EatingVoltage/KNOBZ/hw/knobz kit bom.xlsx

KNOBZ BOM | total price | 45.81
part name trivial | part name trading | link | price per piece | parts price | amt
front plate |  |  | 3 | 3 | 1
pcb |  |  | 14 | 14 | 1
backplate |  |  | 3 | 3 | 1
 |  |  |  | 0
potentiometer | rv09 |  | 0.1 | 2 | 20
fader |  |  | 1 | 10 | 10
oled | 0.91 Inch 128x32 IIC I2C white OLED | https://de.aliexpress.com/item/1005008640132638.html | 1.3 | 1.3 | 1
lidar | vl53l0x |  | 1.5 | 1.5 | 1
minijack connector | PJ-3240-5A |  | 0.15 | 0.45 | 3
subminiature toggle | smts-102 | https://de.aliexpress.com/item/4000226769848.html | 1 | 1 | 1
 |  |  |  | 0
M2x4 screw panhead | M2x4 screw panhead - H1.5mm | https://www.aliexpress.com/item/1005002357962115.html | 0.025 | 0.35 | 14
M2x10 SK |  |  |  | 0 | 14
threaded insert | M2x7 round Standoff Spacer Female M2 Brass Threaded Spacer | https://de.aliexpress.com/item/1005003126118423.html?scm_id=1007.40196.442820.0&scm-url=1007.40196.442820.0 | 0.015 | 0.21 | 14
 |  |  |  | 0
3dp case |  |  | 2 | 2 | 1
3dp bottom spacer |  |  | 1 | 1 | 1
 |  |  |  | 0
knobs |  |  | 0.2 | 4 | 20
fadercaps |  |  | 0.2 | 2 | 10
 |  |  |  | 0
 |  |  |  | 0
