EatingVoltage/KNOBZ/hw/case.3mf

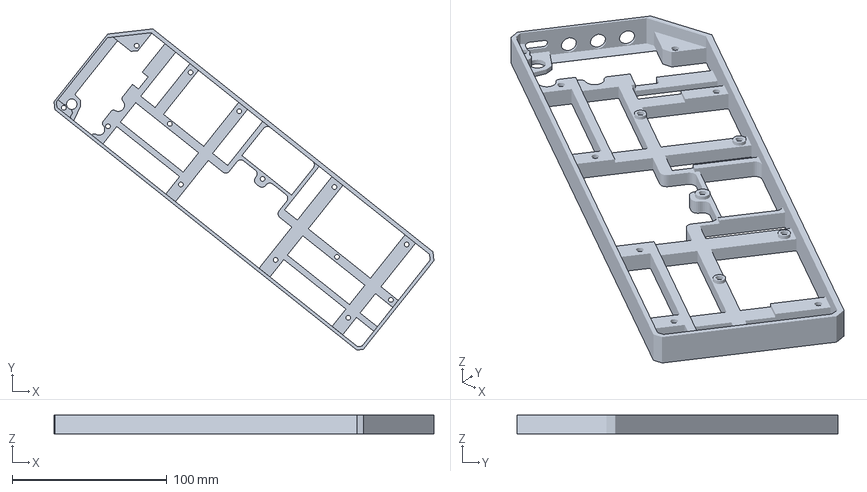
[picture p1: CAD file, 2026-10-17]
hw/case.3mf
245.4 x 207.5 x 12.2 mm
