EatingVoltage/KNOBZ/hw/bottom spacer.3mf

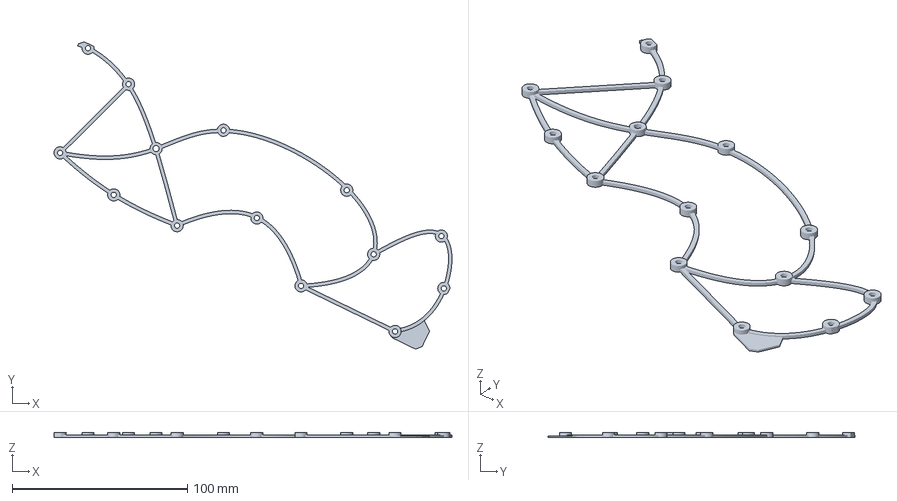
[picture p2: CAD file, 2026-10-17]
hw/bottom spacer.3mf
227.1 x 175.3 x 3.00 mm
