EatingVoltage/KNOBZ/src/io/button.h

#include <Arduino.h>

// this file contains structures for easily reading buttons. provides advanced reading: tapped, held etc...
#define BUTTON_LONG_PRESS_TIME 500
#define BUTTON_TAP_TIME 300
#define BUTTON_AMT 4 // buttons outputting midi notes

struct Button
{
    bool input = false;   // input buffer
    bool didHold = false; // this stores if button was long pressed
    long t0 = 0;

    // user vars. read these to use button.
    bool fell = false;    // read this to see if fell
    bool rose = false;    // read this to see if rose
    bool pressed = false; // read this to see if buttton is pressed at the time
    bool tapped = false;  // read this to see if tapped
    bool held = false;    // read this to see if held
};

Button minButton;
Button maxButton;
Button modeButton;
Button sensorSwitch; // lidar toggle switch (bit 7) - latches, sends a held midi note
Button controllerButton[BUTTON_AMT];

void updateButton(Button &myButton, bool inputVal, long tFrame) // inputVal false = button pressed down
{
    // set vars to default state
    myButton.tapped = false;
    myButton.held = false;
    myButton.fell = false;
    myButton.rose = false;

    myButton.input = inputVal;                // read input
    if (!myButton.input && !myButton.pressed) // new button press
    {
        myButton.didHold = false; // reset temp variable
        myButton.pressed = true;
        myButton.fell = true;
        myButton.t0 = tFrame;
    }

    if (myButton.input && myButton.pressed) // button released
    {
        myButton.pressed = false;
        myButton.rose = true;

        if (tFrame - myButton.t0 < BUTTON_TAP_TIME)
        {
            myButton.tapped = true;
        }
    }

    if (!myButton.didHold && myButton.pressed && (tFrame - myButton.t0 > BUTTON_LONG_PRESS_TIME)) // if button was held long enough
    {
        myButton.held = true;
        myButton.didHold = true;
    }
}

// seed the sensor switch from the current pin state so an already-on switch at
// power-up does NOT fire a note on the first frame (boot-edge suppression).
// requires shiftInUpdate() to have run (inputValues valid).
void sensorSwitchInit()
{
    bool b = shiftInReadBit(7); // false = switch in sensor-ON position (active low)
    sensorSwitch.input = b;
    sensorSwitch.pressed = !b;
}

void updateButtons()
{
    updateButton(minButton, shiftInReadBit(4), millis());
    updateButton(maxButton, shiftInReadBit(5), millis());
    updateButton(modeButton, shiftInReadBit(6), millis());
    updateButton(sensorSwitch, shiftInReadBit(7), millis());
    updateButton(controllerButton[0], shiftInReadBit(0), millis());
    updateButton(controllerButton[1], shiftInReadBit(1), millis());
    updateButton(controllerButton[2], shiftInReadBit(2), millis());
    updateButton(controllerButton[3], shiftInReadBit(3), millis());
}

void debugButtons()
{

    // debugging
    for (byte i = 0; i < 7; i++)
    {
        if (shiftInReadBit(i))
        {
            oledAt(i * 20, 1, 0);
            oled.print(i);
        }
        else
            oledPrint(F("  "), i * 15, 1, 0);
    }

    // if (minButton.pressed)
    //     oledPrint("min");
    // else if (maxButton.pressed)
    //     oledPrint("max");
    // else if (modeButton.pressed)
    //     oledPrint("mod");
    // else oledPrint("   ");
    // for (byte i = 0; i < 4; i++)
    // {
    //     if (controllerButton[i].fell)
    //     {

    //         oledPrint("Button " + String(i) + " pressed", 0, 0, 1);
    //         delay(500);
    //     }
    // }
}
