EatingVoltage/KNOBZ/src/draw.h

#include <Arduino.h>

// draws presetName x-centered in the big font on the given row.
// animate = reveal letter-by-letter (~60ms/char, like the KNOBZ splash).
// trailing blanks are trimmed; an all-blank name draws nothing.
void drawNameCentered(byte row, bool animate)
{
    byte len = NAME_LEN;
    while (len > 0 && presetName[len - 1] == ' ')
        len--;
    if (len == 0)
        return; // unnamed slot -> leave the line blank

    oledAt((128 - len * 8) / 2, row, 1); // ZevvPeep8x16 is 8px wide
    for (byte i = 0; i < len; i++)
    {
        oled.print(presetName[i]);
        if (animate)
            myDelay(60);
    }
}

void showHeader() // shows cc and channel on top of oled
{
    oledAt(0, 0, 0);
    oled.print(F("CC: "));
    oled.print(knob[activeKnob].midiCC);

    byte x = 90;
    if (knob[activeKnob].midiChannel + 1 < 10)
        x += 8;
    oledAt(x, 0, 0);
    oled.print(F("CH: "));
    oled.print(knob[activeKnob].midiChannel + 1);
}

void showHome()
{
    oled.clear();
    showHeader();
    oledAt(0, 3, 0);
    oled.print(F("MIN:"));
    oledPrintPad3(knob[activeKnob].min);
    oledAt(85, 3, 0);
    oled.print(F("MAX:"));
    oledPrintPad3(knob[activeKnob].max);

    byte x = 58;
    if (activeKnob < 10)
        x += 4;
    oledAt(x, 0, 3);
    oled.print(activeKnob + 1);
}

byte oldActiveKnob = 0;

void drawMin(byte col, byte style)
{
    oledAt(col, 2, style);
    oled.print(F("MIN:"));
    oledPrintPad3(knob[activeKnob].min);
}

void drawMax(byte col, byte style)
{
    oledAt(col, 2, style);
    oled.print(F("MAX:"));
    oledPrintPad3(knob[activeKnob].max);
}

void drawHome()
{
    if (activeKnob != oldActiveKnob || redrawOled)
    {
        oldActiveKnob = activeKnob;
        if (minButton.pressed)
            drawMin(0, 1);
        else if (maxButton.pressed)
            drawMax(74, 1);
        else
            showHome();
        redrawOled = false; // reset flag
    }

    else if (minButton.fell)
        drawMin(0, 1);
    else if (maxButton.fell)
        drawMax(74, 1);
    else if (minButton.rose || maxButton.rose)
        showHome();
}
