EatingVoltage/KNOBZ/(commit log)

2020-09-06 saving not working yet
    [config.h, controller.h, main.cpp, menu.h, oled.h]
2020-09-06 nicer led animations, and startup
2020-09-10 added cc/ch conflict warning: cc/ch taken, small fixes
    [animateNeopixel.h, config.h, lidar.h, main.cpp, menu.h, midiIO.h, midiRouting.h, ws2812.h]
2020-09-10 Revert "added cc/ch conflict warning: cc/ch taken, small fixes"
    This reverts commit 1f6fa925f1a66c57c38a7c7b8362a31e5f2d43a0.
    [animateNeopixel.h, config.h, lidar.h, main.cpp, menu.h, midiIO.h, midiRouting.h, ws2812.h]
2020-09-10 cleaned up menu, added clear all, set all channels, reset min max routines
    [menu.h]
2020-09-10 added hardware pin for midi out indicator support
2020-09-20 porting to prototype 0.2.
2020-10-18 got usbmidi uartmidi conversion working and program memory down enough to fit!
2021-02-19 new hardware knob layout, bugfixes, menu repeats, self-initializing, memory optimisation
    [analogMux.h, config.h, controller.h, lidar.h, main.cpp, menu.h, sendMidi.h, shiftIn.h]
2021-03-18 fixing jitter by adding running average to all knobs
    [analogMux.h, animateNeopixel.h, config.h, controller.h, draw.h, main.cpp, menu.h, midiIO.h]
2021-03-20 added proper potentiometer software filtering
2021-04-13 bug fixes, small features
    [Ledling.h, analogMux.h, animateNeopixel.h, button.h, config.h, controller.h, draw.h, lidar.h]
2021-04-21 minor bugfixes, lidar working
    [controller.h]
2026-06-07 optimize flash, kill arduino String
2026-06-07 add button channel menu option
2026-06-07 add save slot naming
2026-06-07 fix oled value flicker
    [controller.h, menu.h]
2026-06-17 add lidar enable switch also sends midi note
2026-10-15 Add printable enclosure parts for owners
    Case, button cap (x7) and bottom spacer STLs from Fusion, plus a
    README with PETG / 0.2 mm / no-support print settings.
2026-10-15 Set all channels: show the real channel on first draw
    menu.currentVal is stale when the edit screen first opens; read the
    channel from the editing knob instead (stored 0-15, shown 1-16).
2026-10-15 Set all channels: drop duplicated channel print from PR #2 merge
    The merge kept both versions of the line, so the channel printed twice
    (channel 1 showed as "11").
2026-10-17 Add the hardware as built: the EasyEDA export, Y371 and Y377 as JLCPCB made them, the kit BOM
    Copied from production files/ so DeviceWizard can pin them by commit; hw/README.md says what each file is (hashes, the kit's hand parts).
